NiklasHammerstone/PrYlf-Laser/README.md

# PrYlf-Laser
This repository contains the documentation for a homemade Pr:Ylf-Laser.
## Update 27.10.2022 Green Ouput and report finished!
I was able to use a dichroic mirror and a plane outcoupler to couple the green output out of the setup. The output powers are much lower than with orange or red, but it definitely works! The report, in which the setup and results are documented in a paper-like fashion, is also finished. Although much can be improved (see report), I am currently considering this project as finished.
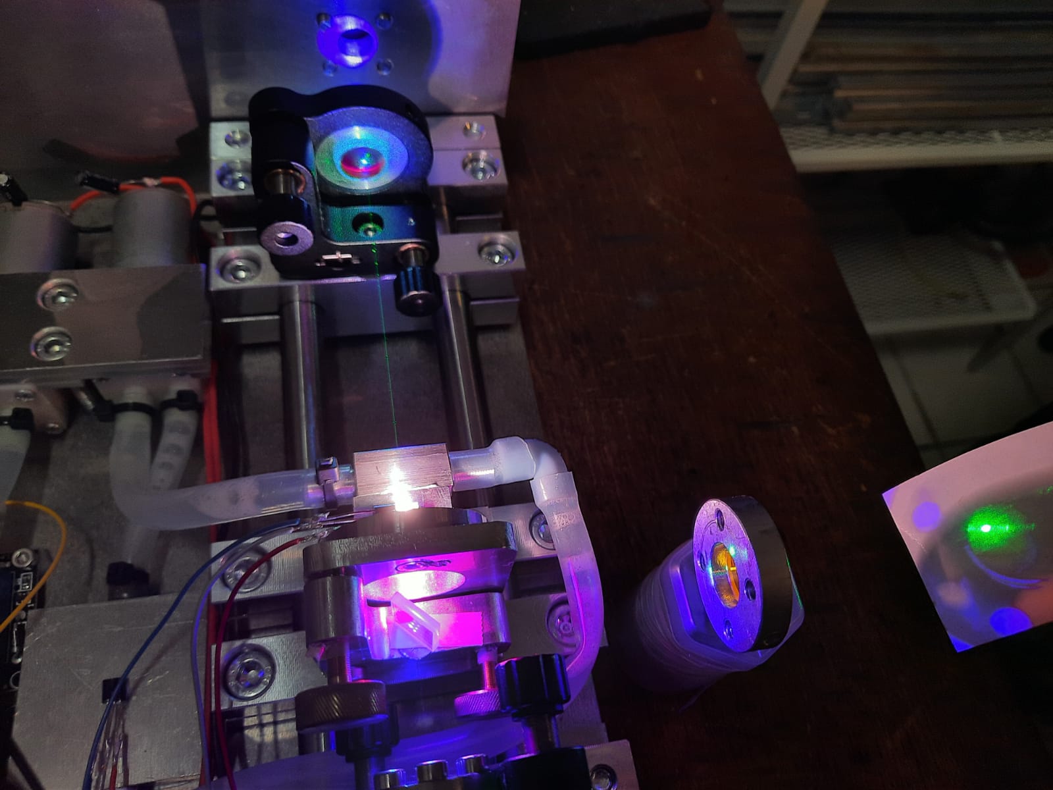
[picture p1: Documentation/prylf523dichro2.jpeg]
523nm Laseraction


## Update 19.01.2021 Orange Output!
Using another mirror, the lasers now also lases at the orange line (604nm). The output power is similar to the 630nm line, but not quite as high. 
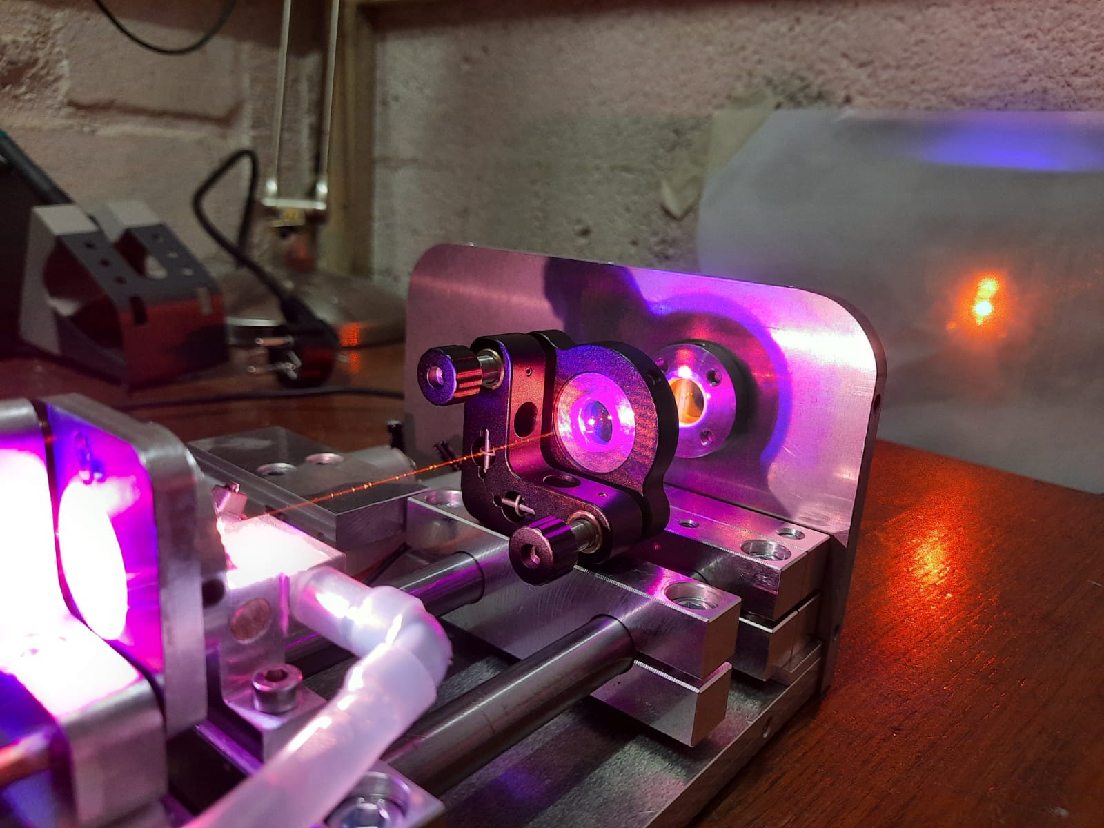
[picture p2: Documentation/Intracavity604nm.jpeg]
604nm Laseraction


## Update 18.01.2021 Intracavity green!
I was able to use a specialized mirror to successfully amplify the green (523nm) line of the Pr:Ylf crystal. Now I need to find a way to couple it out..
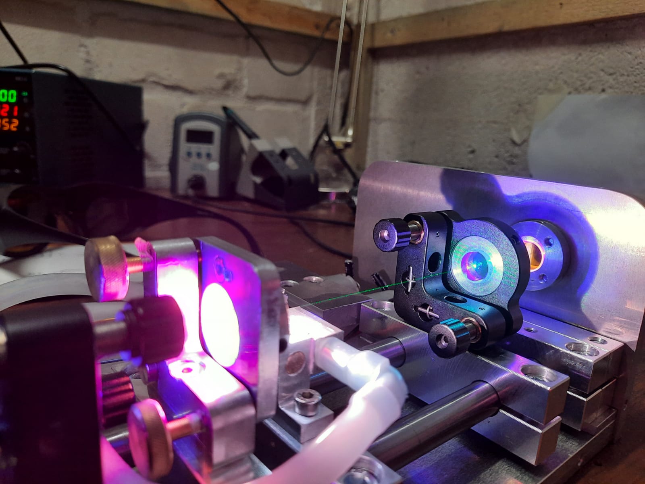
[picture p3: Documentation/PrYlf523_2.jpeg]
Intracavity green


## Update 28.11.2021 First red light!
The laser module now emits red light at around 630nm. The divergence seems to be around 1.7mrad. 

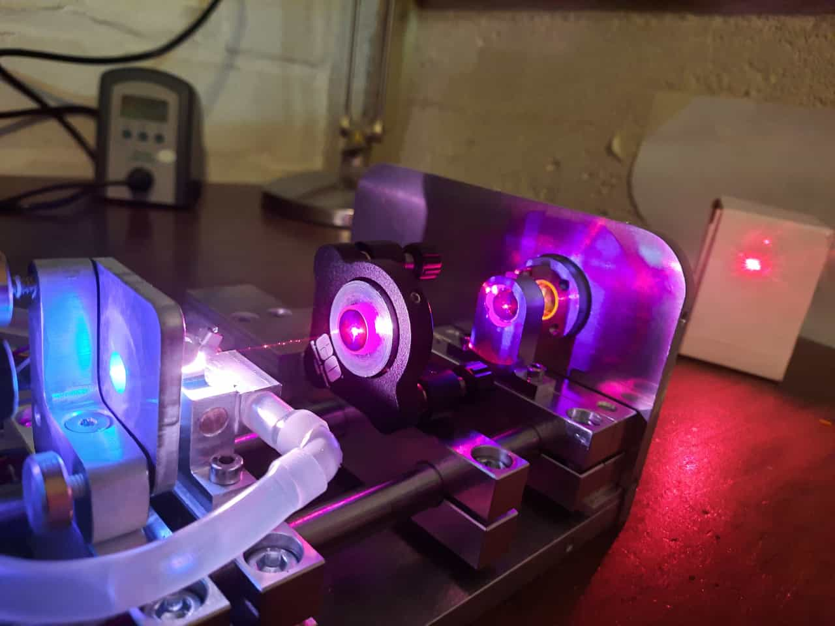
[picture p4: Documentation/RedPrylf1.jpeg]
Laser action


The module can produce quite high order TEM-modes, but a TEM00-Mode can of course be obtained.

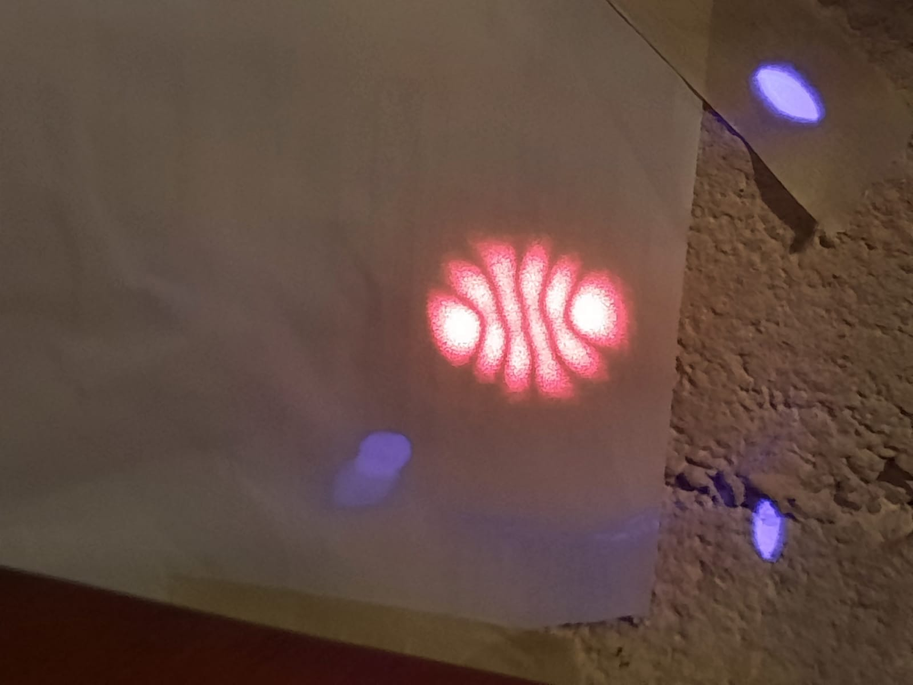
[picture p5: Documentation/Mode1.jpg]
High order TEM mode
