NiklasHammerstone/PrYlf-Laser/Report/Praseodymium doped LiYF4 Lasers emitting at 630nm 604nm and 523nm.pdf

# Diode pumped P r³⁺:LiYF4 lasers emitting at 640 nm, 604 nm and 523 nm

Niklas H.

Abstract—In this report, a Praseodymium doped LiYF4 (Pr:YLF) laser consisting of a hemispheric cavity of 50 mm (640 nm) or 100 mm (604nm/523nm) and a 6mm long longitudinally pumped crystal (0.8 at% doping) is reported. Depending on the mirror set used, the 640 nm (³P0 to 3F2), 607 nm (³P0 to 3H6) and 523 nm (³P0 to 3H5) lines of the P r³⁺-Ion can be amplified. Slope effiencies of 28.4%, 5.6% and 2.5% respectively were reached with maximum output powers of 149 mW, 26 mW and 4.3 mW. Index Terms—LiYF4 Laser, DPSS Laser, Pr:YLF Laser

I. INTRODUCTION

Since the introduction of lasers in 1960 by Theodore Maiman, many gain media for obtaining optical gain and therefore laser action have been introduced. One of these media is LiYF4 doped with P r³⁺-Ions (Pr:YLF), which is able to operate at multiple lines, e.g. 720nm, 607nm, 640nm and 523nm, which is why special research efforts have been directed towards this material. It is also one of the few gain media which directly (without frequency doubling) emit visible light and also are pumped by visible light. Furthermore, continous wave UV emission by intracavity doubling has been reported [7][2]. For this report, the 640 nm (³P0 to 3F2), 607 nm (³P0 to 3H6) and 523 nm (³P0 to 3H5) transitions are of relevance. The P r³⁺-Ion reaches the excited state 3P0 by being excited to the 3P2 state and fastly relaxing to 3P0. The excitation process is performed most efficiently by using 444nm pumplight. Since InGaN laser diodes emit around this exact wavelength and are commercially available at several watts of optical power, they have been used extensively for pumping Pr:YLF lasers [9][3][1][4][6]. For linear end-pumped resonator designs using InGaN laser diodes, slope efficiencies of 49% for 523 nm, 40% at 607 nm and 57% for 640 nm have been reported [5].

II. EXPERIMENTAL SETUP

The resonator setups for amplifying the 607 nm and 640 nm lines are a standard hemispherical cavity with the concave outcoupling mirror as reported in e.g. [5] and [1]. The setup is depicted in figure 1. For 607 nm and 640 nm output couplers (OC) with 1% T and 1.8% T are used. The radius of curvature (ROC) and therefore cavity length is 100 mm and 50 mm respectively. The Pr:YLF crystal used has a doping concentration of 0.8 at% and is 6 mm long. The faces of the crystal are coated with an antireflection coating for 444 nm and 500 nm - 720 nm. It is placed directly in front of the high reflecting mirror (HR), with about 2 mm of air between them. The crystal is glued into an aluminium holder using a thermal glue, in order to passively cool it down. This holder


Fig. 1. Setup for 607 nm and 640 nm laser output

was designed to be water-cooled as well, but this did not prove to be necessary at the power levels produced by the pump diode. A HR with high transmission at 444 nm and high reflectivity at 600 nm - 700 nm are used. The crystal is pumped longitudinally.
For pumping, a Nichia NDB7875 laser diode is used. The diode is selected to have an output wavelength of 444 nm at 1.5 A, which corresponds to 2 W of output power. The pump diode is collimated using an aspheric lens with f = 4.2 mm (Thorlabs A390TM-A) and focussed into the crystal via a biconvex lens with f = 50 mm (Thorlabs LB1844-A). Both pump optics were delivered with a VIS antireflection coating. The pump diode is water cooled. Since the absorption coefficient of Pr:YLF is highly dependent on polarization [9], the pump diode is rotated until the absorption peaks and then locked rotationally to match the pump polarization and the crystal orientation.
Due to availability issues, a different setup for obtaining 523 nm laser output is implemented. This setup is depicted in figure 2. In this case, the concave mirror is coated with a very

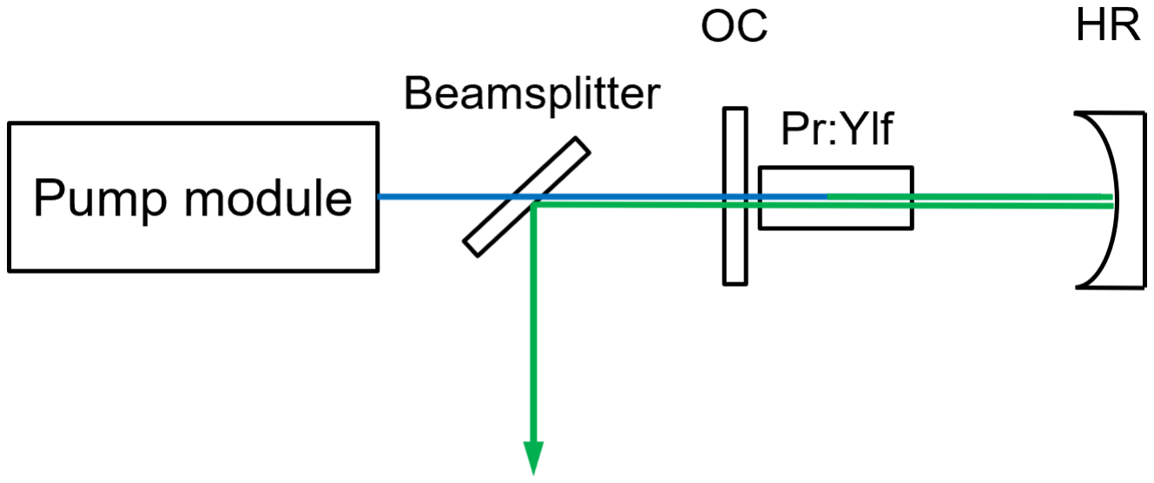
[picture p11: figure]

Fig. 2. Setup for 523 nm laser output

high reflective coating (≥ 99.9% R) for 523 nm. The plane mirror is used as the output coupler, with a transmission of about 0.5% for 523 nm. A beamsplitter with high transmission for the pumplight and high reflectivity for 523 nm is installed to guide the laser beam out of the setup.

III. RESULTS AND DISCUSSION

For measuring the output power of the lasers, each setup is optimized at a set pump power above threshold. Mirror distance and adjustment are fine-tuned for maximum output power. // The output power of each setup is measured using a photodiode power sensor (Thorlabs S121C with PM100D console). The data can be found in the figures 3, 4 and 5.


Fig. 3. Output power at 640 nm over pump power


Fig. 4. Output power at 604 nm over pump power

For the 640 nm setup, a lasing threshold Pth of about 130 mW was achieved. The slope efficiency ηsl was measured to be 28.4%. A maximum output power of Pmax = 149 mW was observed. For the 607 nm, Pth was 200 mW, with ηsl = 5.6% and Pmax = 26 mW. Both the higher threshold and lower slope efficiency are to be expected since the emission cross section σem of Pr:YLF at 604 nm is lower than at 640 nm [8]. // The power measurements reveal a rather unusual effect: Both the 604 nm and 640 nm setups scale linearly with the pump powers until about 600 mW of pump power. Beyond 600 mW, the output power starts to saturate and even declines when the pump power is increased more. This effect is pronounced even more in the 523 nm setup (see fig. 5). Here, the linear region is relatively small which is due to the higher lasing threshold of 520 mW. This leaves only 100 mW of linear scaling (ηsl = 2,5%) until the effect mentioned above sets in at around 650 mW. The much lower slope effiency and Pmax=4,3 mW can again be contributed to lower values for σem at 523 nm although the difference of ηsl for 640 nm and 523 nm is much larger than in the literature [8]. It is likely that the power degradation effect is due to power dependencies of the mode

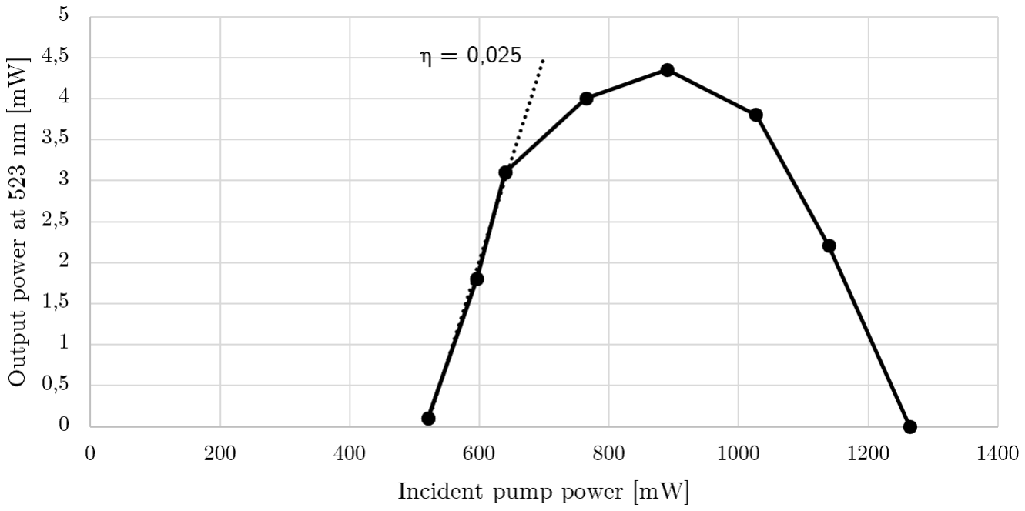
[picture p12: figure]

Fig. 5. Output power at 523 nm over pump power

structure of the pump diode, which would greatly affect the pump-mode overlap and thus output power. Thermal effects can be ruled out since the effect could be detected across all diode temperatures. Also, current dependent wavelength shifts are unlikely to cause this effect since the laser diode was selected to emit 444 nm at 1500 mA which means that the laser should reach maximum efficiency when approaching this current. Thermal lensing is a possible factor but can not be the main reason since the effect does not creep in slowly whilst the crystal heats up but appears at a very predictable pump power.
Due to the lower emission cross sections and thus amplification factors at 523 nm and 604 nm combined with relatively high resonator lengths, both setups are relatively sensitive to misalignments, with the 523 nm setup much more unstable than the 604 nm setup. The 640 nm setup is extraordinarly insensitive to misalignments, resonator lengths of 25 - 50 mm result in reliable laser output, with the power increasing when the resonator length approaches the stability limit at L = 50 mm. The lower misalignment sensitivity is likely due to a smaller mode waist of the shorter resonator and thus higher power density in the pumped region of the crystal and therefore stronger amplification combined with a lower ”leverage” of the short focal length output coupler. This leads to lower displacements of the mode waist inside the crystal for the same angular movement of the mirror (compared to a longer local length mirror).
As mentioned above, the slope effiencies and maximum laser powers achieved in this work are lower than in the reported literature (e.g. [8], [5]) which can be attributed to multiple factors. Most importantly, no pump beam shaping techniques besides collimation and focussing where deployed which almost definitely decreases the pump-mode overlap efficiency in the Pr:YLF crystal. Furthermore, the output coupling of the resonators was not optimized. The resonator setups were tuned to local maxima but it is possible that the absolute maximum possible output powers were not reached.

IV. CONCLUSION
In this work, setups for amplifying the 523 nm, 604 nm and 640 nm lines of the Pr:YLF crystal were presented and characterized. Slope effiencies of 2.5%, 5.6% and 28.4% respectively were reached with maximum output powers of 4.3 mW, 26 mW and 149 mW. Higher output powers were prevented by a degradation effect starting at around 600 mW of pump power which can likely be attributed to the pump diode. This effect is currently the subject of further examination. Nevertheless, successful lasing was shown for all three setups with the results being in qualitative agreement with the literature.
V. ACKNOWLEDGEMENTS
The author would like to thank the staff of the Institute of Applied Optics and Electronics at the University of Applied Sciences Cologne for providing the opportunity to make laser power measurements in their laboratories.

REFERENCES
[1] A.-R. Bellancourt et al. “Blue diode pumped solid-state lasers for digital projection”. In: Laser Physics 20.3 (2010), pp. 643–648. ISSN: 1054-660X. DOI: 10.1134/ S1054660X10050026. (https://doi.org/10.1134/S1054660X10050026)
[2] Teoman Gun, Philip Metz, and G ¨ | unter Huber. “Efficient ¨
continuous wave deep ultraviolet Pr 3+ :LiYF 4 laser at 261.3 nm”. In: Applied Physics Letters 99.18 (2011),
p. 181103. ISSN: 0003-6951. DOI: 10.1063/1.3657150. (https://doi.org/10.1063/1.3657150)
[3] Christian Krankel et al. “Out of the blue: semiconductor ¨ laser pumped visible rare-earth doped lasers”. In: Laser & Photonics Reviews 10.4 (2016), pp. 548–568. ISSN: 18638880. DOI: 10.1002/lpor.201500290. (https://doi.org/10.1002/lpor.201500290)
[4] Saiyu Luo et al. “Diode-pumped 915-nm Pr:YLF laser passively mode-locked with a SESAM”. In: Optics express 26.19 (2018), pp. 24695–24701. DOI: 10.1364/OE. 26.024695. (https://doi.org/10.1364/OE.26.024695)
[5] Saiyu Luo et al. “Power scaling of blue-diode-pumped Pr:YLF lasers at 523.0, 604.1, 606.9, 639.4, 697.8 and 720.9 nm”. In: Optics Communications 380 (2016), pp. 357–360. ISSN: 00304018. DOI: 10.1016/j.optcom. 2016.06.026. (https://doi.org/10.1016/j.optcom.2016.06.026)
[6] S. Muller et al. “Dual wavelength and switchable laser operation of Pr<sup>3+</sup>:LiYF<inf>4</inf> crystals at 523 nm and 640 nm”. In: 2011 Conference on Lasers and Electro-Optics Europe and 12th European Quantum Electronics Conference (CLEO EU-ROPE/EQEC). IEEE, 2011, p. 1. ISBN: 978-1-4577-0533-5. DOI: 10.1109/CLEOE.2011.5942436. (https://doi.org/10.1109/CLEOE.2011.5942436)
[7] A. Richter et al. “Continuous-wave ultraviolet generation at 320 nm by intracavity frequency doubling of redemitting Praseodymium lasers”. In: Optics express 14.8 (2006), pp. 3282–3287. DOI: 10.1364/OE.14.003282. (https://doi.org/10.1364/OE.14.003282)
[8] A. Richter et al. “Power scaling of semiconductor laser pumped Praseodymium-lasers”. In: Optics express 15.8 (2007), pp. 5172–5178. DOI: 10.1364/oe.15.005172. (https://doi.org/10.1364/oe.15.005172)
[9] B. Xu et al. “Highly efficient InGaN-LD-pumped bulk Pr:YLF orange laser at 607nm”. In: Optics Communications 305 (2013), pp. 96–99. ISSN: 00304018. DOI: 10.1016/j.optcom.2013.05.002. (https://doi.org/10.1016/j.optcom.2013.05.002)
