NiklasHammerstone/PrYlf-Laser/Documentation/Module604nm.jpeg

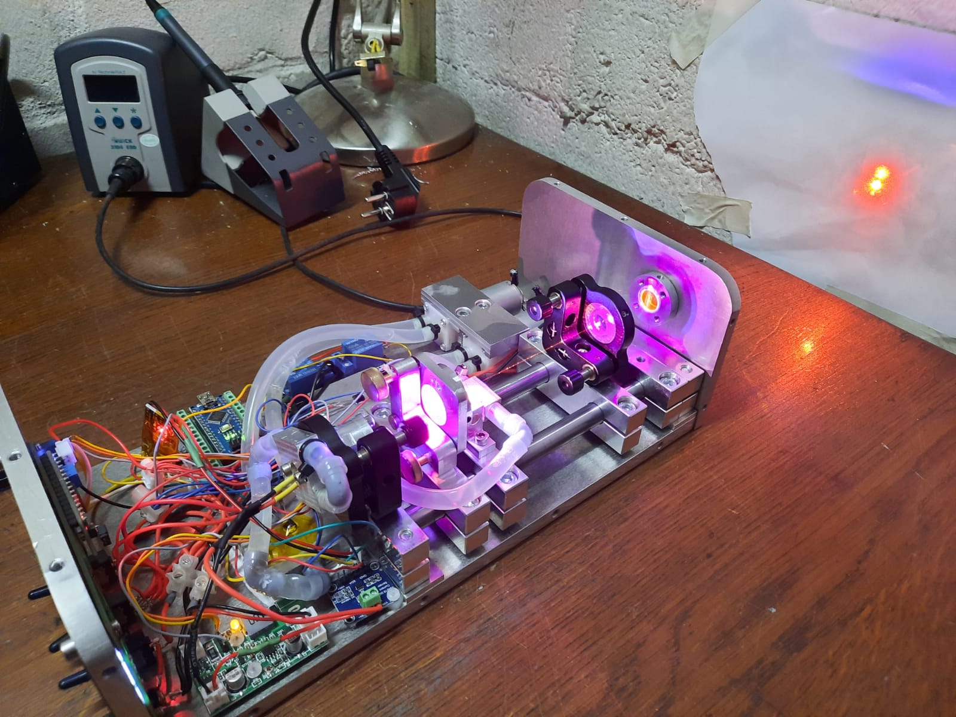
Documentation/Module604nm.jpeg
