NiklasHammerstone/PrYlf-Laser/Documentation/PrYlf523_1.jpeg

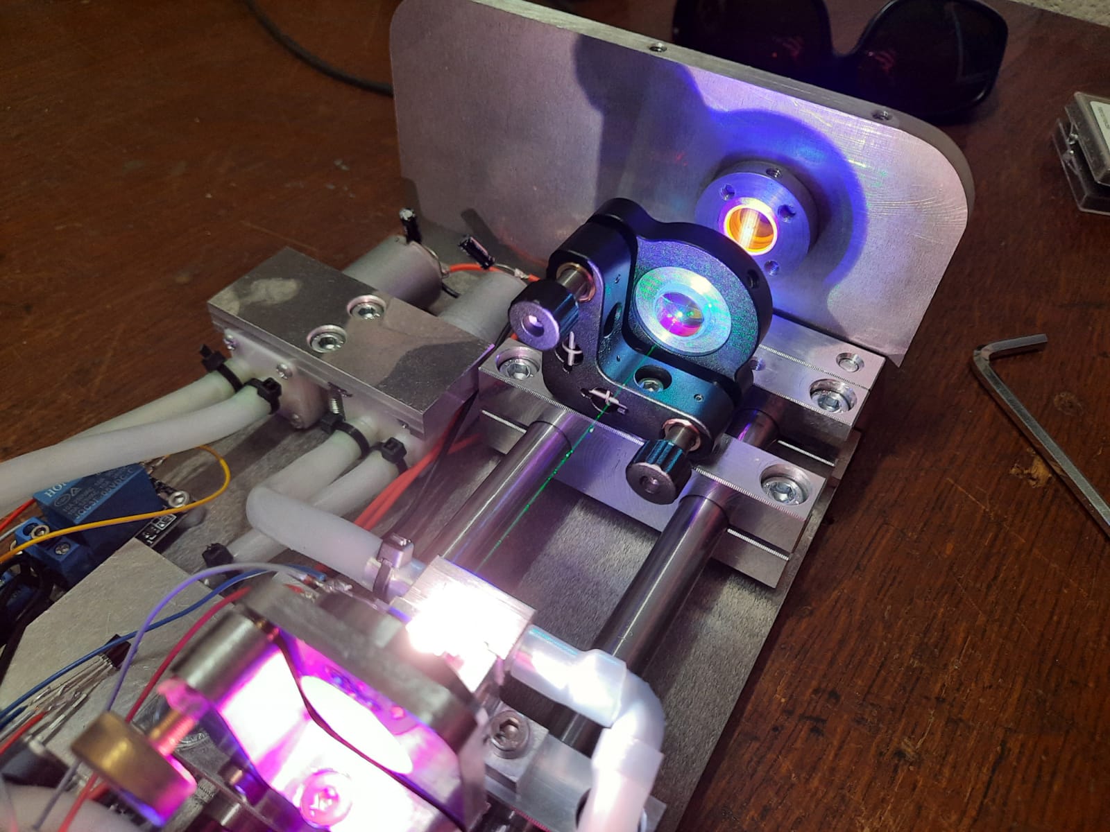
Documentation/PrYlf523_1.jpeg
