NiklasHammerstone/PrYlf-Laser/Documentation/PrYlf523_overview.jpeg

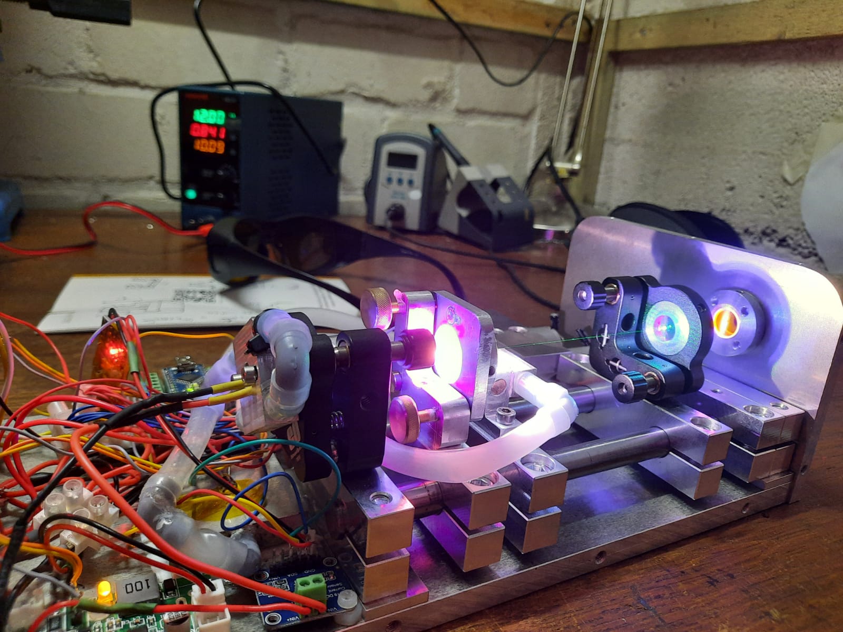
Documentation/PrYlf523_overview.jpeg
