NiklasHammerstone/PrYlf-Laser/Documentation/PrYlf523_withcrystal.jpeg

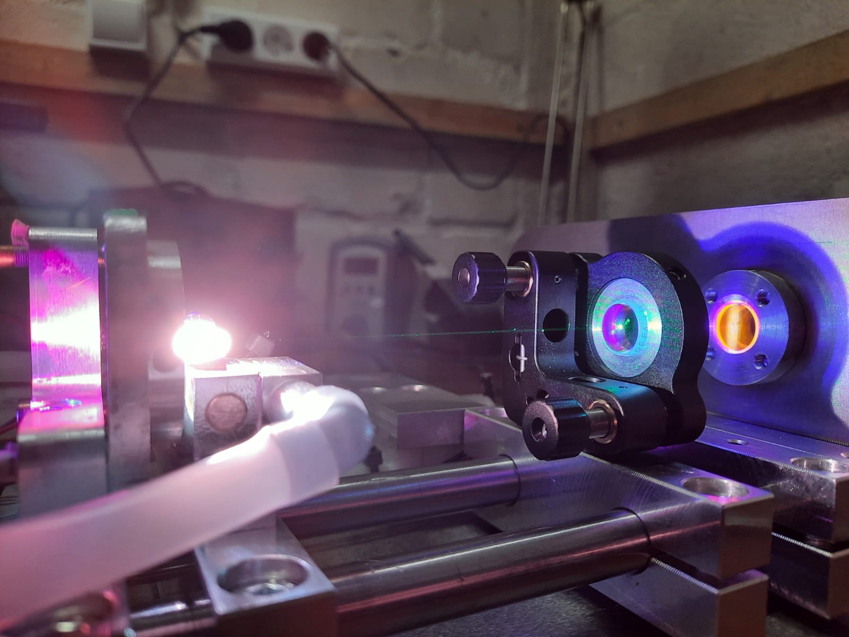
Documentation/PrYlf523_withcrystal.jpeg
