NiklasHammerstone/PrYlf-Laser/Documentation/prylf523dichro.jpeg

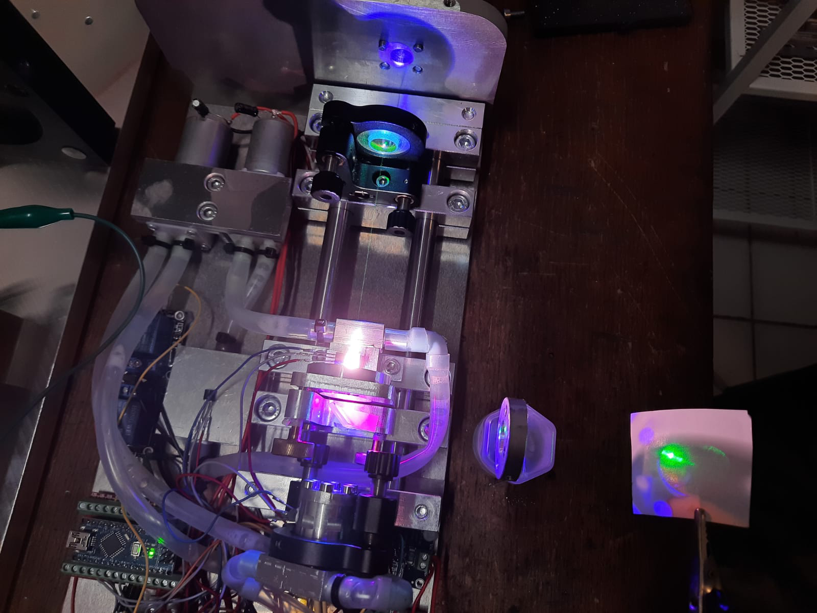
Documentation/prylf523dichro.jpeg
