NiklasHammerstone/PrYlf-Laser/Documentation/Measurements.xlsx

Sheet: 604nm (2)
 | 604nm line multimode (old measurement) |  | mirror distance 101mm
Diode current [mA] | Diode power (mW) | Output power [mW] | Laser threshold [mW]
297 |  | 0.7
357 |  | 2.55
403 |  | 4.9
451 |  | 8.8
506 |  | 11.7
558 |  | 14
598 |  | 15.3
648 |  | 18.2
700 |  | 20.1
751 |  | 20.5
800 |  | 21.1
900 |  | 20.5
998 |  | 18

Sheet: 640nm
 | 640nm line
Diode current [mA] | Diode power (mW) | Output power [mW] | Laser threshold [mW]
236 | 123.1288 | 8.3
300 | 203.02 | 29
400 | 327.85 | 62
500 | 452.68 | 107
600 | 577.51 | 134
700 | 702.34 | 140
800 | 827.17 | 149
900 | 952 | 134
1000 | 1076.83 | 103

Sheet: 604nm
 | 604nm line
Diode current [mA] | Diode power (mW) | Output power [mW] | Laser threshold [mW]
300 | 203.02 | 0.5
400 | 327.85 | 5.5
500 | 452.68 | 13.3
600 | 577.51 | 21.2
700 | 702.34 | 24.1
800 | 827.17 | 25.8
900 | 952 | 24.8
1000 | 1076.83 | 20

Sheet: 523nm
 | 523nm line
Diode current [mA] | Diode power (mW) | Output power [mW] | Laser threshold [mW]
555 | 521.3365 | 0.1 | 555
615 | 596.2345 | 1.8
650 | 639.925 | 3.1
750 | 764.755 | 4
850 | 889.585 | 4.35
960 | 1026.898 | 3.8
1050 | 1139.245 | 2.2
1150 | 1264.075 | 0
outcoupler measurement
