NiklasHammerstone/PrYlf-Laser/Documentation/PrYlf-Laser_Schematic.pdf

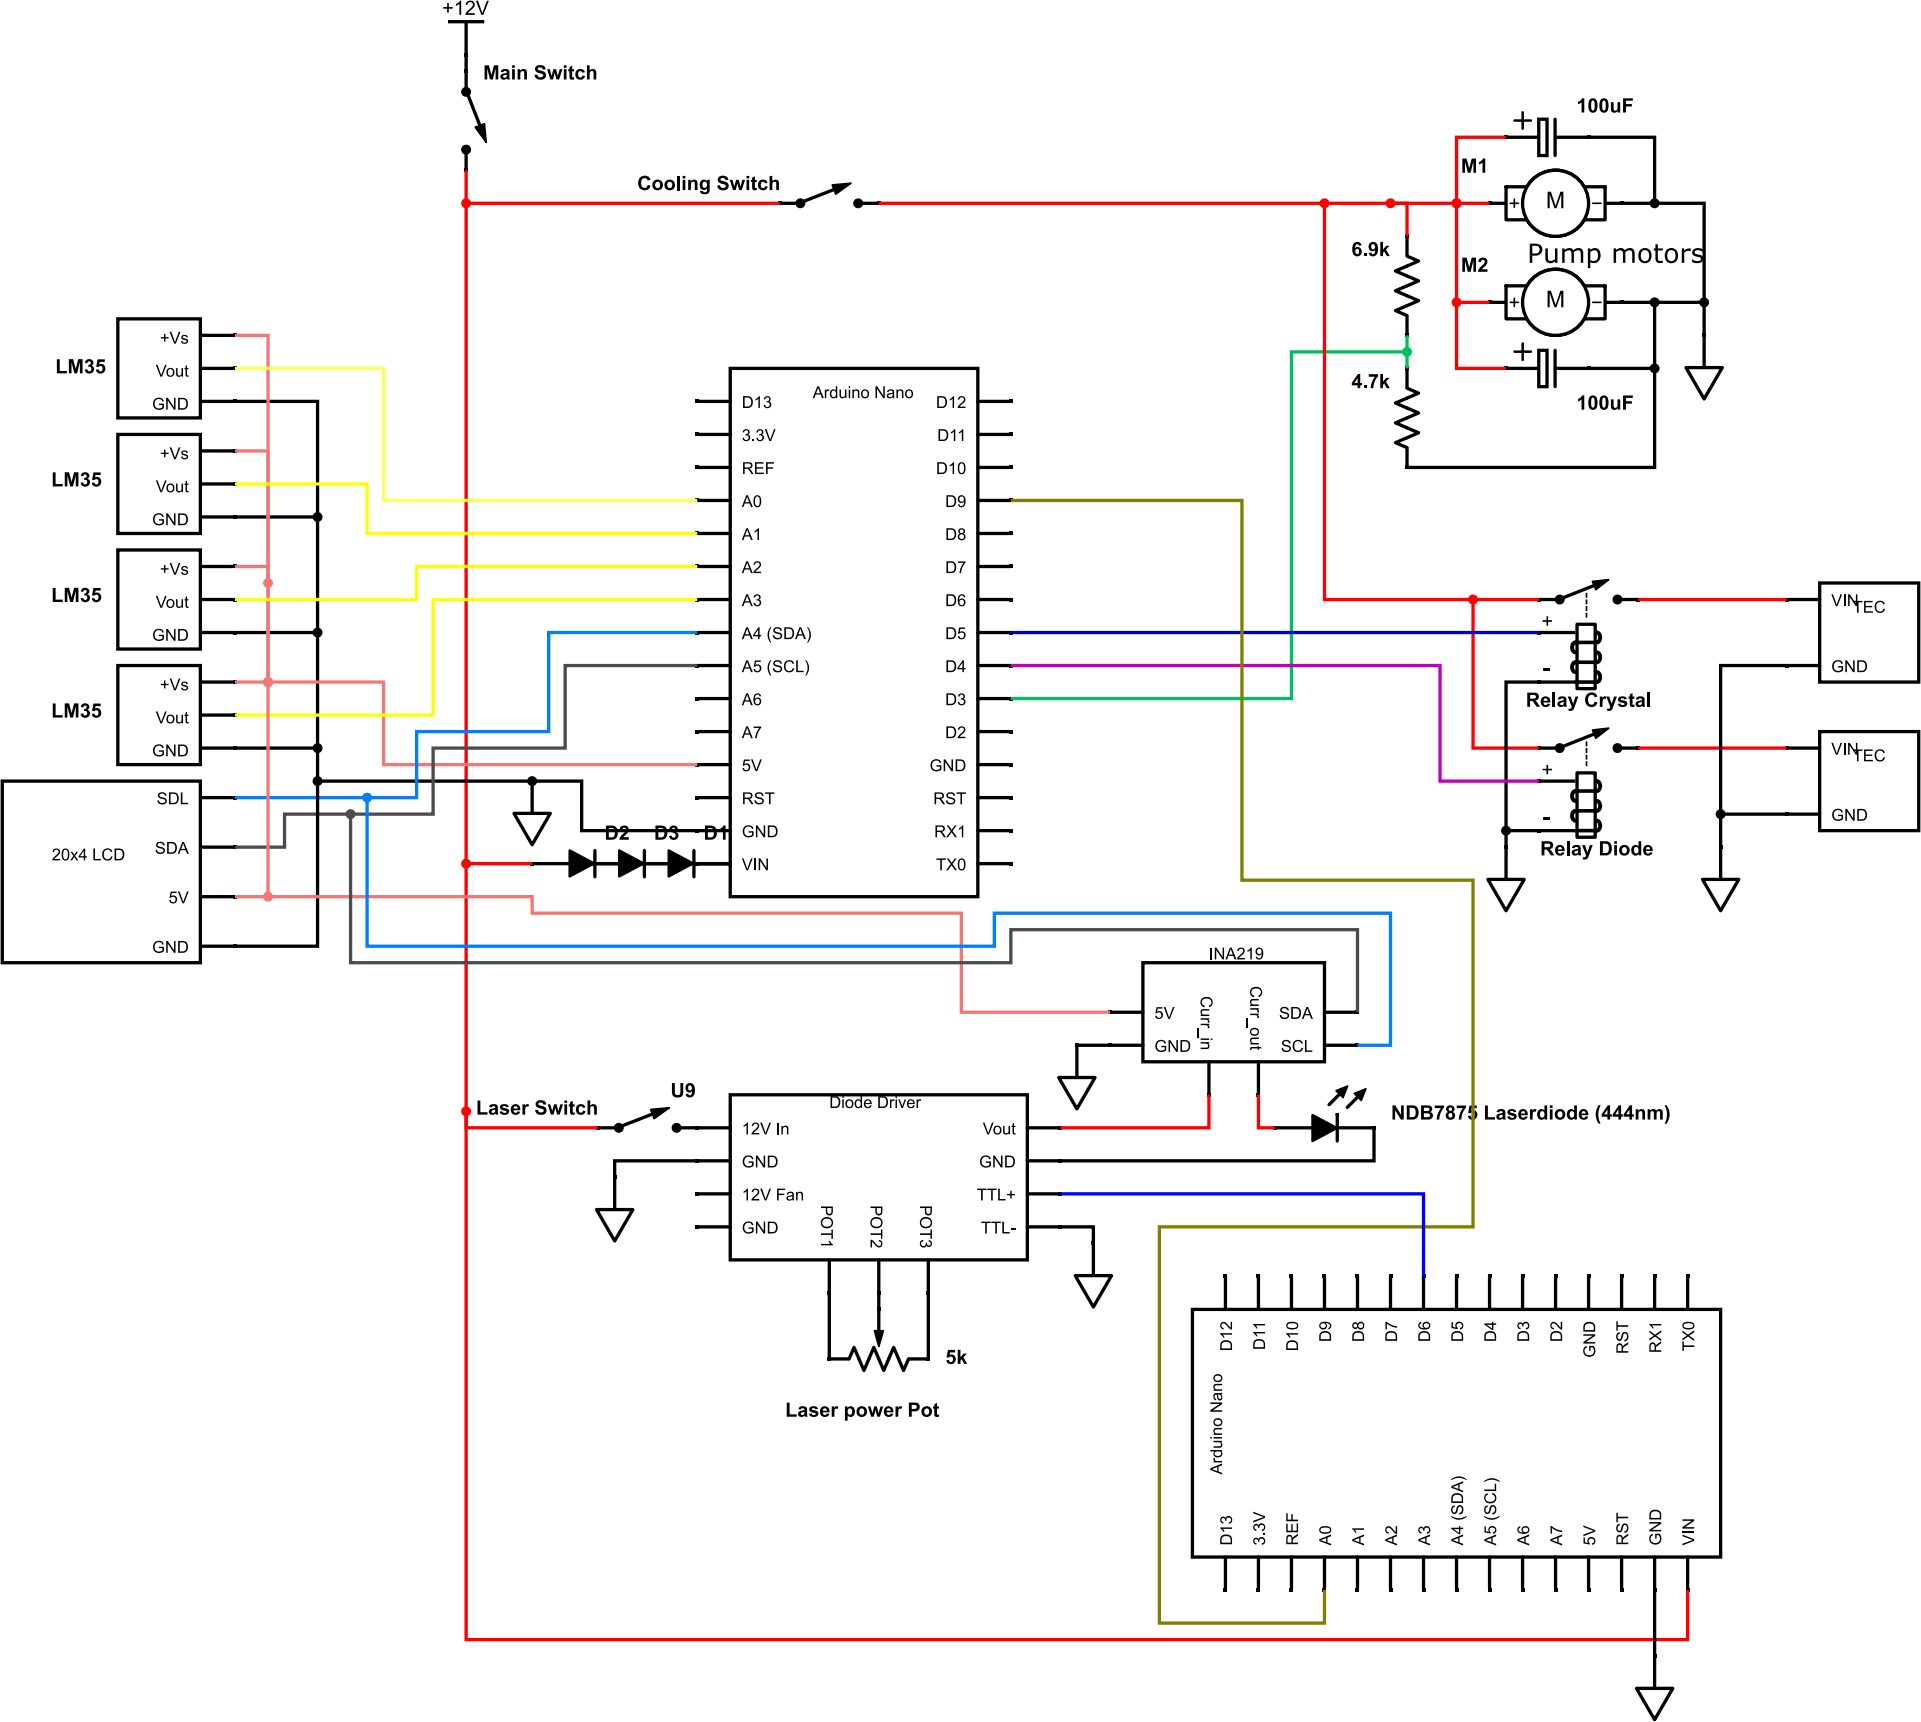
[picture p18: page 1]
