NiklasHammerstone/PrYlf-Laser/(commit log)

2021-11-28 Added the Arduino Firmware
2021-12-05 Added the schematic
2021-12-05 Added the CAD Files
2022-01-19 Added operation at 523nm and 604nm
2022-10-26 Measured output power of Pr:YLF lines
    [Measurements.xlsx]
2022-10-26 Report is almost done, proofreading is only Todo
    [Measurements.xlsx]
2022-10-27 Added pictures of 523nm setup
